eddyem/scorpio/kicad/stm8_platform/stepper_bom.ods

Component | Description | Value | Footprint | Quantity Per PCB |  | ЦЕНА
1 |  | 0.1 | C_0805_HandSoldering | 3 | есть
2 |  | 1u | C_0805_HandSoldering | 1 | 100 | 237
3 | Polarised capacitor | 47мкФ, 10В | CP_Tantalum_Case-C_EIA-6032-28_Hand | 1 | 50 | 85
4 |  | белый светодиод | LED_0805 | 1 | 25 | 140
5 | TVS Diode Array, 5.5V Standoff, 4 Channels, SOT-23-5 package | SP0504BAHT | SOT-23-5_HandSoldering | 1 | 25 | 240
6 | Connector, single row, 01x05, pin header | SWIM | штыревой разъем угловой 1x40 («мама») | 1 | (PBS-1x40R) 25 | 460
7 | Connector, single row, 01x04, pin header | UART | Pin_Header_Angled_1x04_Pitch2.54mm | 1 | -
8 | Transistor P-MOSFET with substrate diode (general) | AO3401 | SOT-23_Handsoldering | 3 | есть
9 | Transistor N-MOSFETwith substrate diode (general) | SI2300 | SOT-23_Handsoldering | 3 | есть
10 |  | 10k | R_0805_HandSoldering | 10 | есть
11 |  | 220 | R_0805_HandSoldering | 4 | есть
12 |  | 330 | R_0805_HandSoldering | 3 | есть
13 |  | 470 | R_0805_HandSoldering | 1 | есть
14 | 3x DIP Switch, Single Pole Single Throw (SPST) switch, small symbol | dip-переключатель 3 позиции | DIP-6_W7.62mm | 1 | 10 | 700
15 |  | LD1117S50CTR | SOT-223 | 1 | 20 | 235
16 |  | STM8S105K4T6C | LQFP-32_7x7mm_Pitch0.8mm | 1 | 10 | 1000
17 | Darlington Transistor Arrays | ULN2803A | SOIC-18W_7.5x11.6mm_Pitch1.27mm | 1 | 10 | 430
18 | Stepper driver | DRV8825PWP | HTSSOP (28) | 2 | 10 | 2700
 |  |  |  |  | сумма: | 6227
