eddyem/scorpio/kicad/stm8_platform/stepper_sch.pdf

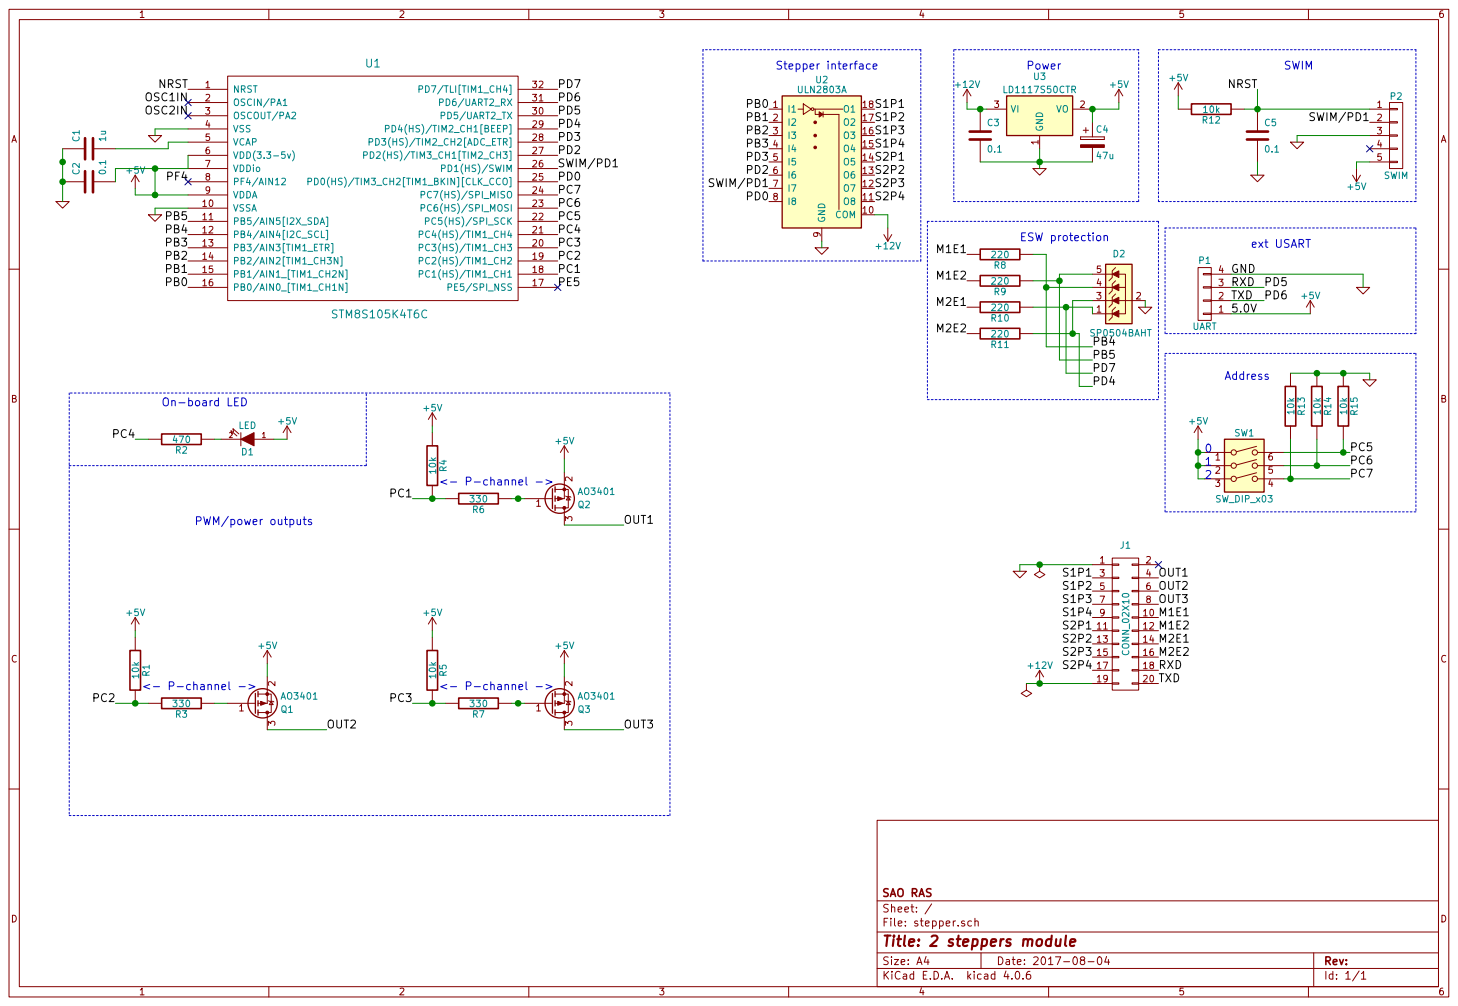
[picture p1: page 1]

+5V | SWIM

5 P2 SWIM SWIM/PD1 3

File: stepper.sch Sheet: / SAO RAS

Id: 1/1 Title: 2 steppers module
