eddyem/scorpio/kicad/stm8_platform/stepper-brd.pdf

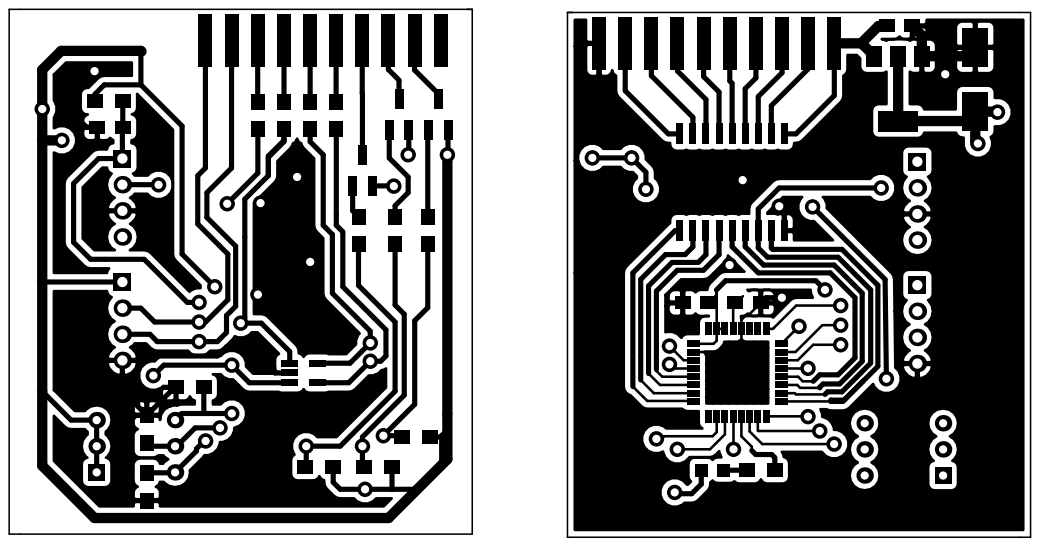
[picture p2: page 1]
