eddyem/scorpio/kicad/stm8_platform/shutter.kicad_pcb

## KiCad design kicad/stm8_platform/shutter.kicad_pcb (2018-12-14)

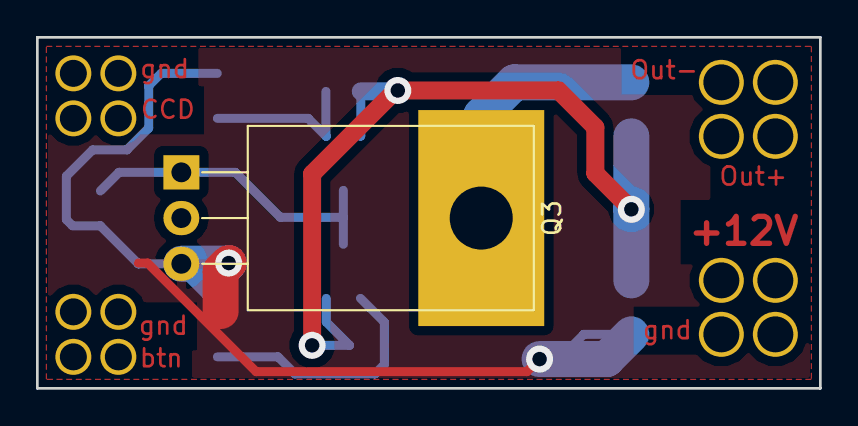
[picture p3: board shutter.kicad_pcb from above]

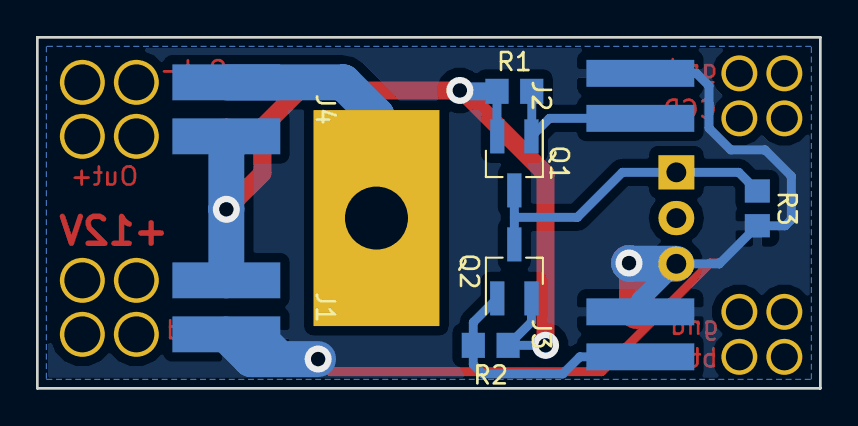
[picture p4: board shutter.kicad_pcb from below]

Board: 2 copper layers, 43.5 x 19.5 mm, 10 parts (9 on the bottom side), 6 nets.

Parts:
J1: Power; 2PIN_Pwr
J2: CCD; 2PIN
J3: Button; 2PIN
J4: Sutter; 2PIN_Pwr
Q1, Q2: AO3407; SOT-23_Handsoldering
Q3: IRL3303; TO-220-3_Horizontal_TabDown
R1, R2, R3: 47k; R_0805_2012Metric_Pad1.29x1.40mm_HandSolder

Connections:
+12V: J1.2, J4.1, Q1.2, Q2.2, R1.1, R2.1
GND: J1.1, J2.1, J3.1, Q3.3, R3.2
unnamed: J2.2, Q1.1, R1.2
unnamed: J3.2, Q2.1, R2.2
unnamed: J4.2, Q3.2
unnamed: Q1.3, Q2.3, Q3.1, R3.1
