eddyem/scorpio/kicad/stm8_platform/stepper_motherboard.kicad_pcb

## KiCad design kicad/stm8_platform/stepper_motherboard.kicad_pcb (2018-12-14)

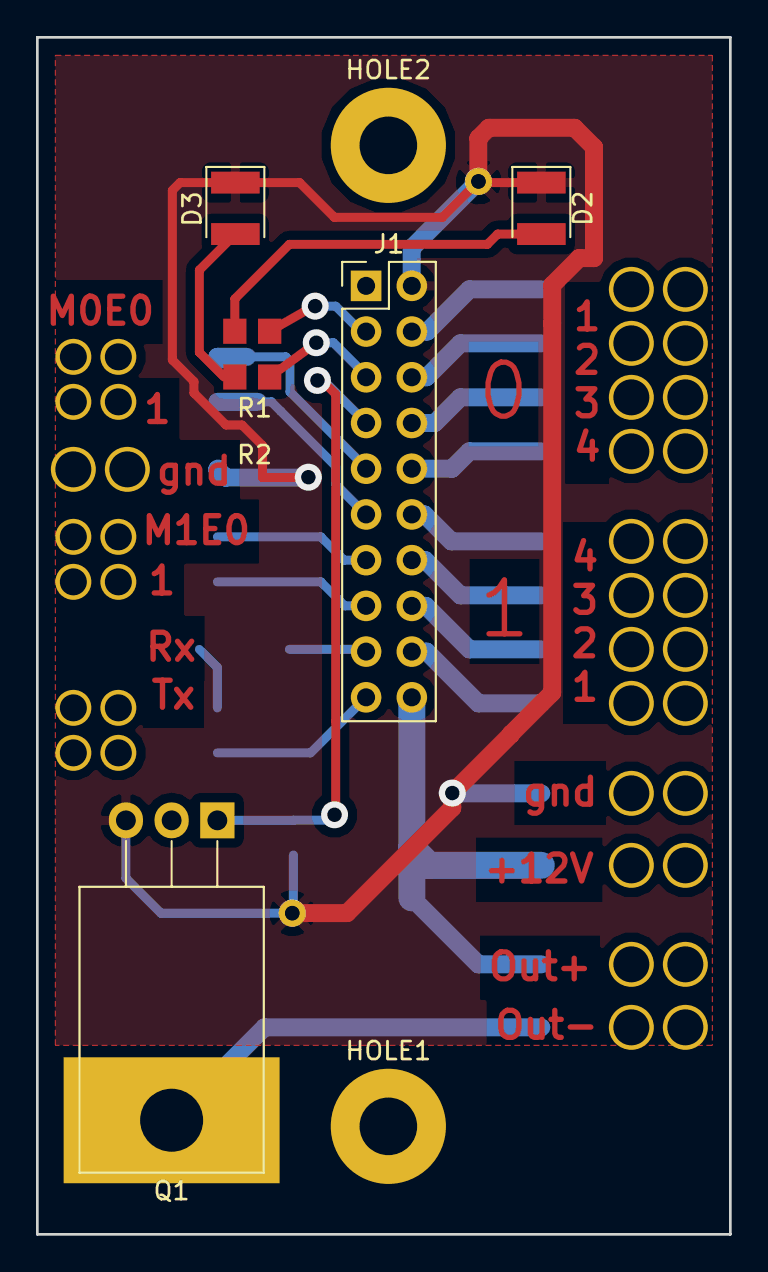
[picture p5: board stepper_motherboard.kicad_pcb from above]

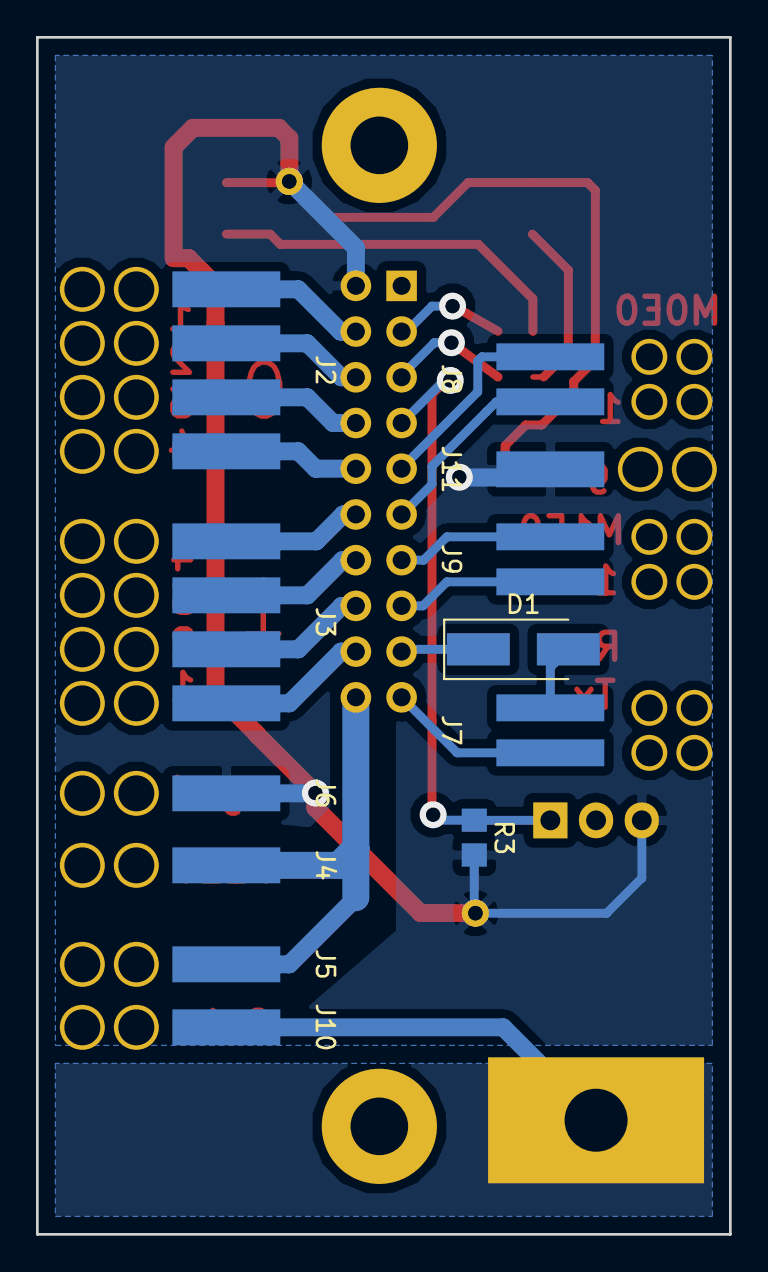
[picture p6: board stepper_motherboard.kicad_pcb from below]

Board: 2 copper layers, 38.5 x 66.5 mm, 20 parts (12 on the bottom side), 23 nets.

Parts:
D1: SS14; D_SMA_Handsoldering
D2, D3: LED; LED_1210_3225Metric_Pad1.22x2.70mm_HandSolder
HOLE1, HOLE2: HOLE; MountingHole_3.2mm_M3_Pad
J1: CONN_02X10; PinHeader_2x10_P2.54mm_Vertical
J2: Motor1; 4PIN
J3: Motor2; 4PIN
J4: 12V; 1PIN
J5: Load_12V; 1PIN
J6: GND; 1PIN
J7: UART; 2PIN
J8: Esw0; 2PIN
J9: Esw1; 2PIN
J10: Load_GND; 1PIN
J11: ESW_GND; 1PIN
Q1: IRL3303; TO-220-3_Horizontal_TabDown
R1, R2: 47; R_0805_2012Metric_Pad1.29x1.40mm_HandSolder
R3: 10k; R_0805_2012Metric_Pad1.29x1.40mm_HandSolder

Connections:
/M1E1: J1.9, J8.1
/M1E2: J1.11, J8.2
/M2E1: J1.13, J9.1
/M2E2: J1.15, J9.2
/OUT1: J1.3, R1.1
/OUT2: J1.5, R2.1
/OUT3: J1.7, Q1.1, R3.1
/RXD: J1.19, J7.2
/S0P1: J1.4, J2.4
/S0P2: J1.6, J2.3
/S0P3: J1.8, J2.2
/S0P4: J1.10, J2.1
/S1P1: J1.18, J3.1
/S1P2: J1.16, J3.2
/S1P3: J1.14, J3.3
/S1P4: J1.12, J3.4
/TXD: D1.1, J1.17
GND: D2.1, D3.1, J1.2, J6.1, J11.1, Q1.3, R3.2
unnamed: D1.2, J7.1
unnamed: D2.2, R1.2
unnamed: D3.2, R2.2
unnamed: J1.20, J4.1, J5.1
unnamed: J10.1, Q1.2
