eddyem/scorpio/kicad/stm8_platform/stepper.kicad_pcb

## KiCad design kicad/stm8_platform/stepper.kicad_pcb (2018-12-14)

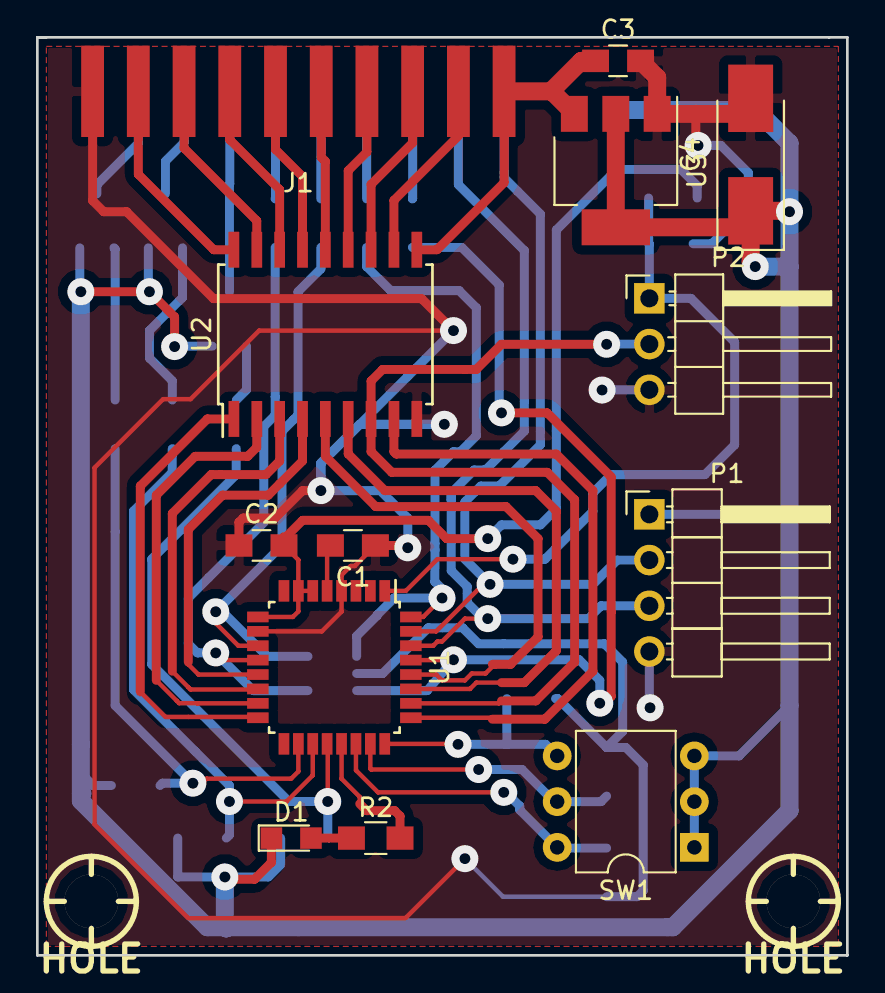
[picture p7: board stepper.kicad_pcb from above]

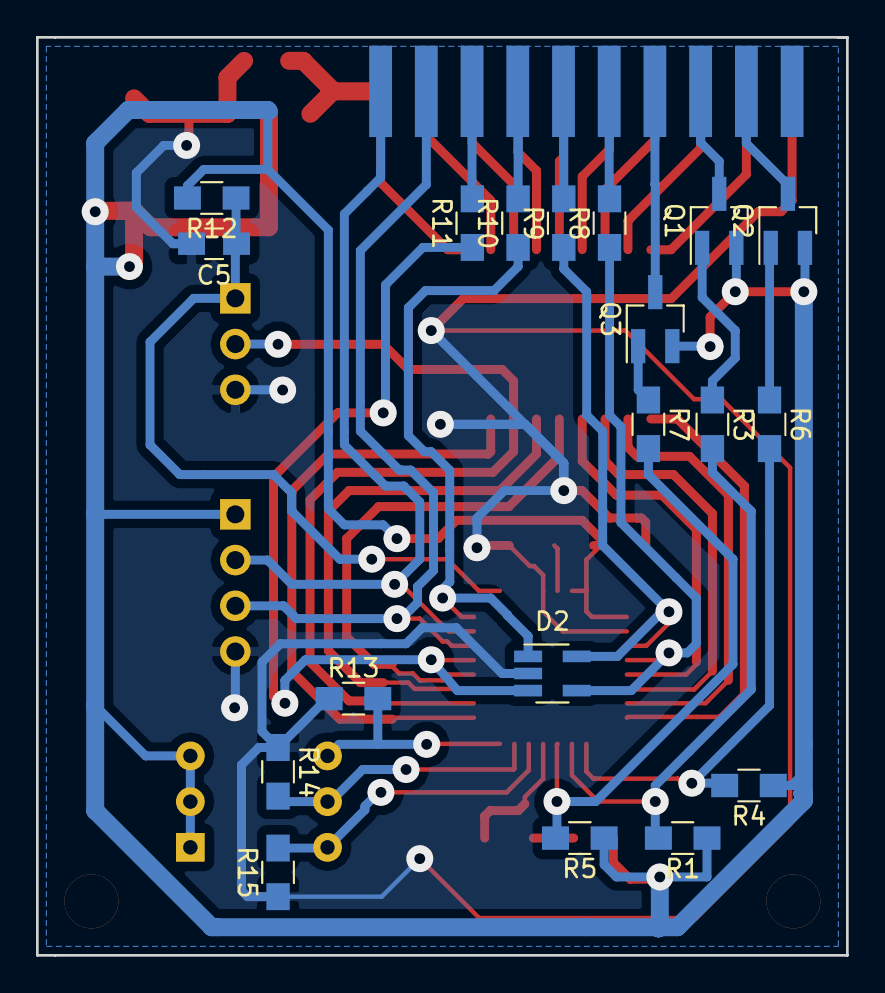
[picture p8: board stepper.kicad_pcb from below]

Board: 2 copper layers, 45.0 x 51.0 mm, 34 parts (19 on the bottom side), 45 nets.

Parts:
C1: 1u; C_0805_HandSoldering
C2, C3, C5: 0.1; C_0805_HandSoldering
C4: 47u; CP_Tantalum_Case-C_EIA-6032-28_Hand
D1: LED; LED_0805
D2: SP0504BAHT; SOT-23-5_HandSoldering
HOLE1, HOLE2: HOLE; hole_3mm
J1: CONN_02X10; Pin_header_2x10_side
P1: UART; Pin_Header_Angled_1x04_Pitch2.54mm
P2: SWIM; PinHeader_1x03_P2.54mm_Horizontal
Q1, Q2, Q3: AO3401; SOT-23_Handsoldering
R1, R4, R5, R12, R13, R14, R15: 10k; R_0805_HandSoldering
R2: 470; R_0805_HandSoldering
R3, R6, R7: 330; R_0805_HandSoldering
R8, R9, R10, R11: 220; R_0805_HandSoldering
SW1: SW_DIP_x03; DIP-6_W7.62mm
U1: STM8S105K4T6C; LQFP-32_7x7mm_Pitch0.8mm
U2: ULN2803A; SOIC-18W_7.5x11.6mm_Pitch1.27mm
U3: LD1117S50CTR; SOT-223

Connections:
+5V: C2.2, C4.1, D1.1, P1.1, Q1.2, Q2.2, Q3.2, R1.1, R4.1, R5.1, R12.2, SW1.1, SW1.2, SW1.3, U1.6, U1.7, U1.9, U3.2, U3.4
+12V: C3.1, J1.19, U2.10, U3.3
/M1E1: J1.10, R8.2
/M1E2: J1.12, R9.2
/M2E1: J1.14, R10.2
/M2E2: J1.16, R11.2
/NRST: C5.1, P2.1, R12.1, U1.1
/OUT1: J1.4, Q2.3
/OUT2: J1.6, Q1.3
/OUT3: J1.8, Q3.3
/PB0: U1.16, U2.1
/PB1: U1.15, U2.2
/PB2: U1.14, U2.3
/PB3: U1.13, U2.4
/PB4: D2.4, R8.1, U1.12
/PB5: D2.5, R9.1, U1.11
/PC1: R4.2, R6.2, U1.18
/PC2: R1.2, R3.2, U1.19
/PC3: R5.2, R7.2, U1.20
/PC4: R2.2, U1.21
/PC5: R15.2, SW1.6, U1.22
/PC6: R14.2, SW1.5, U1.23
/PC7: R13.2, SW1.4, U1.24
/PD0: U1.25, U2.8
/PD2: U1.27, U2.6
/PD3: U1.28, U2.5
/PD4: D2.3, R11.1, U1.29
/PD5: J1.18, P1.3, U1.30
/PD6: J1.20, P1.2, U1.31
/PD7: D2.1, R10.1, U1.32
/S1P1: J1.3, U2.18
/S1P2: J1.5, U2.17
/S1P3: J1.7, U2.16
/S1P4: J1.9, U2.15
/S2P1: J1.11, U2.14
/S2P2: J1.13, U2.13
/S2P3: J1.15, U2.12
/S2P4: J1.17, U2.11
/SWIM/PD1: P2.2, U1.26, U2.7
GND: C1.1, C2.1, C3.2, C4.2, C5.2, D2.2, J1.1, P1.4, P2.3, R13.1, R14.1, R15.1, U1.4, U1.10, U2.9, U3.1
unnamed: C1.2, U1.5
unnamed: D1.2, R2.1
unnamed: Q1.1, R3.1
unnamed: Q2.1, R6.1
unnamed: Q3.1, R7.1
