eddyem/scorpio/kicad/stm8_platform/kicad.kicad_pcb

## KiCad design kicad/stm8_platform/kicad.kicad_pcb (2017-08-18)

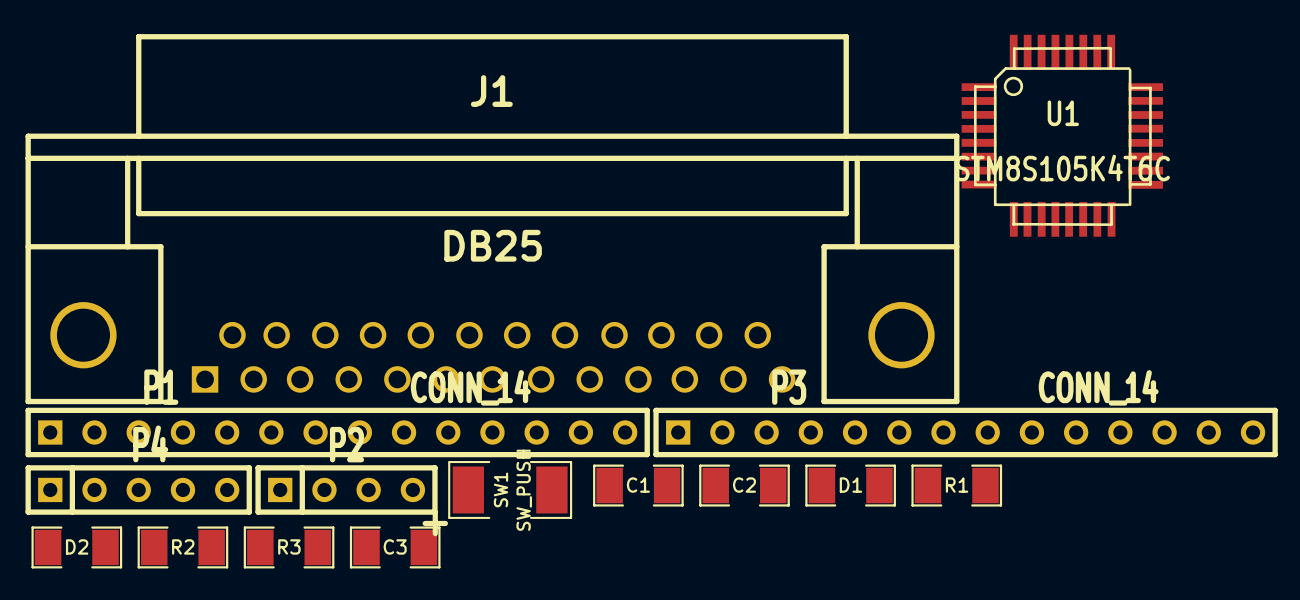
[picture p9: board kicad.kicad_pcb from above]

Board: 2 copper layers, 15 parts (0 on the bottom side), 31 nets, no tracks yet.

Parts:
C1: 1u; SM1206
C2, C3: 104; SM1206
D1, D2: LED; SM1206
J1: DB25; DB25FC
P1, P3: CONN_14; SIL-14
P2: CONN_4; SIL-4
P4: CONN_5; SIL-5
R1, R2: 1k; SM1206
R3: 10k; SM1206
SW1: SW_PUSH; SM2010
U1: STM8S105K4T6C; TQFP32

Connections:
+3.3V: C2.2, D1.1, D2.1, P1.1, P2.1, P4.1, R3.1, U1.6, U1.7, U1.9
/A DIR: J1.9, P1.9, U1.13
/NRST: C3.1, P1.3, P2.3, R3.2, SW1.2, U1.1
/OSC1IN: P1.4, U1.2
/OSC2IN: P1.5, U1.3
/PB0: J1.3, P1.12, U1.16
/PB1: J1.5, P1.11, U1.15
/PB2: J1.7, P1.10, U1.14
/PB4: P1.8, U1.12
/PB5: P1.7, U1.11
/PC1: J1.2, P1.14, U1.18
/PC2: P3.14, R1.2, U1.19
/PC3: P3.13, U1.20
/PC4: P3.12, U1.21
/PC5: P3.11, U1.22
/PC6: P3.10, U1.23
/PC7: P3.9, U1.24
/PD0: P3.8, U1.25
/PD2: J1.6, P3.6, U1.27
/PD3: P3.5, U1.28
/PD4: J1.4, P3.4, U1.29
/PD5: P3.3, P4.4, U1.30
/PD6: P3.2, P4.3, U1.31
/PD7: P3.1, U1.32
/PE5: P1.13, U1.17
/PF4: P1.6, U1.8
/SWIM/PD1: P2.2, P3.7, U1.26
GND: C1.1, C2.1, C3.2, J1.18, J1.19, J1.20, J1.21, J1.22, J1.23, J1.24, J1.25, P1.2, P2.4, P4.5, R2.2, SW1.1, U1.4, U1.10
unnamed: D2.2, R2.1
unnamed: C1.2, U1.5
unnamed: D1.2, R1.1
