eddyem/scorpio/STM8/platform/stm8l.h

/*
 * stm8l.h
 *
 * Copyright 2014 Edward V. Emelianoff <eddy@sao.ru>
 *
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
 * You should have received a copy of the GNU General Public License
 * along with this program; if not, write to the Free Software
 * Foundation, Inc., 51 Franklin Street, Fifth Floor, Boston,
 * MA 02110-1301, USA.
 */


#pragma once
#ifndef __STM8L_H__
#define __STM8L_H__

typedef unsigned char U8;
typedef unsigned int U16;
typedef unsigned long U32;
#define NULL (void*)0

/* functions */
#define enableInterrupts()    {__asm__("rim\n");}    // enable interrupts
#define disableInterrupts()   {__asm__("sim\n");}    // disable interrupts
#define iret()                {__asm__("iret\n");}   // Interrupt routine return
#define pop_ccr()             {__asm__("pop cc\n");} // Pop CCR from the stack
#define push_ccr()            {__asm__("push cc\n");}// Push CCR on the stack
#define rim()                 {__asm__("rim\n");}    // enable interrupts
#define sim()                 {__asm__("sim\n");}    // disable interrupts
#define nop()                 {__asm__("nop\n");}    // No Operation
#define trap()                {__asm__("trap\n");}   // Trap (soft IT)
#define wfi()                 {__asm__("wfi\n");}    // Wait For Interrupt
#define halt()                {__asm__("halt\n");}   // Halt

/*
 * Registers map is shown in short datasheet, page 26
 */
/* GPIO */
#define PA_ODR *(unsigned char*)0x5000
#define PA_IDR *(unsigned char*)0x5001
#define PA_DDR *(unsigned char*)0x5002
#define PA_CR1 *(unsigned char*)0x5003
#define PA_CR2 *(unsigned char*)0x5004

#define PB_ODR *(unsigned char*)0x5005
#define PB_IDR *(unsigned char*)0x5006
#define PB_DDR *(unsigned char*)0x5007
#define PB_CR1 *(unsigned char*)0x5008
#define PB_CR2 *(unsigned char*)0x5009

#define PC_ODR *(unsigned char*)0x500A
#define PC_IDR *(unsigned char*)0x500B
#define PC_DDR *(unsigned char*)0x500C
#define PC_CR1 *(unsigned char*)0x500D
#define PC_CR2 *(unsigned char*)0x500E

#define PD_ODR *(unsigned char*)0x500F
#define PD_IDR *(unsigned char*)0x5010
#define PD_DDR *(unsigned char*)0x5011
#define PD_CR1 *(unsigned char*)0x5012
#define PD_CR2 *(unsigned char*)0x5013

#define PE_ODR *(unsigned char*)0x5014
#define PE_IDR *(unsigned char*)0x5015
#define PE_DDR *(unsigned char*)0x5016
#define PE_CR1 *(unsigned char*)0x5017
#define PE_CR2 *(unsigned char*)0x5018

#define PF_ODR *(unsigned char*)0x5019
#define PF_IDR *(unsigned char*)0x501A
#define PF_DDR *(unsigned char*)0x501B
#define PF_CR1 *(unsigned char*)0x501C
#define PF_CR2 *(unsigned char*)0x501D

#ifdef STM8S105
#define PG_ODR *(unsigned char*)0x501E
#define PG_IDR *(unsigned char*)0x501F
#define PG_DDR *(unsigned char*)0x5020
#define PG_CR1 *(unsigned char*)0x5021
#define PG_CR2 *(unsigned char*)0x5022

#define PH_ODR *(unsigned char*)0x5023
#define PH_IDR *(unsigned char*)0x5024
#define PH_DDR *(unsigned char*)0x5025
#define PH_CR1 *(unsigned char*)0x5026
#define PH_CR2 *(unsigned char*)0x5027

#define PI_ODR *(unsigned char*)0x5028
#define PI_IDR *(unsigned char*)0x5029
#define PI_DDR *(unsigned char*)0x502A
#define PI_CR1 *(unsigned char*)0x502B
#define PI_CR2 *(unsigned char*)0x502C
#endif // STM8S105

/* GPIO bits */
#define GPIO_PIN0       (1 << 0)
#define GPIO_PIN1       (1 << 1)
#define GPIO_PIN2       (1 << 2)
#define GPIO_PIN3       (1 << 3)
#define GPIO_PIN4       (1 << 4)
#define GPIO_PIN5       (1 << 5)
#define GPIO_PIN6       (1 << 6)
#define GPIO_PIN7       (1 << 7)

/* -------------------- FLASH/EEPROM -------------------- */
#define FLASH_CR1   *(unsigned char*)0x505A
#define FLASH_CR2   *(unsigned char*)0x505B
#define FLASH_NCR2  *(unsigned char*)0x505C
#define FLASH_FPR   *(unsigned char*)0x505D
#define FLASH_NFPR  *(unsigned char*)0x505E
#define FLASH_IAPSR *(unsigned char*)0x505F
#define FLASH_PUKR  *(unsigned char*)0x5062 // progmem unprotection
#define FLASH_DUKR  *(unsigned char*)0x5064 // EEPROM unprotection

#define EEPROM_KEY1     0xAE  // keys to manage EEPROM's write access
#define EEPROM_KEY2     0x56
#define EEPROM_START_ADDR  (unsigned char*)0x4000

/* ------------------- interrupts ------------------- */
#define EXTI_CR1    *(unsigned char*)0x50A0
#define EXTI_CR2    *(unsigned char*)0x50A1
#define INTERRUPT_HANDLER(fn, num)      void fn() __interrupt(num)
#define INTERRUPT_DEFINITION(fn, num)   extern void fn() __interrupt(num)

// Reset status register
#define RST_SR      *(unsigned char*)0x50B3

/* ------------------- CLOCK ------------------- */
#define CLK_ICKR        *(unsigned char*)0x50C0
#define CLK_ECKR        *(unsigned char*)0x50C1
#define CLK_CMSR        *(unsigned char*)0x50C3
#define CLK_SWR         *(unsigned char*)0x50C4
#define CLK_SWCR        *(unsigned char*)0x50C5
#define CLK_CKDIVR      *(unsigned char*)0x50C6
#define CLK_SPCKENR1    *(unsigned char*)0x50C7
#define CLK_CSSR        *(unsigned char*)0x50C8
#define CLK_CCOR        *(unsigned char*)0x50C9
#define CLK_PCKENR2     *(unsigned char*)0x50CA
#define CLK_HSITRIMR    *(unsigned char*)0x50CC
#define CLK_SWIMCCR     *(unsigned char*)0x50CD

/* ------------------- Watchdog ------------------ */
#define WWDG_CR         *(unsigned char*)0x50D1
#define WWDG_WR         *(unsigned char*)0x50D2
#define IWDG_KR         *(unsigned char*)0x50E0
#define IWDG_PR         *(unsigned char*)0x50E1
#define IWDG_RLR        *(unsigned char*)0x50E2
// enable Watchdog
#define KEY_ENABLE      (0xCC)
// refresh Watchdog from IWDG_RLR
#define KEY_REFRESH     (0xAA)
// modify IWDG_PR and IWDG_RLR
#define KEY_ACCESS      (0x55)

/* ------------------- AWU, BEEP ------------------- */
#define AWU_CSR1        *(unsigned char*)0x50F0
#define AWU_APR         *(unsigned char*)0x50F1
#define AWU_TBR         *(unsigned char*)0x50F2
#define BEEP_CSR        *(unsigned char*)0x50F3

/* ------------------- SPI ------------------- */
#define SPI_CR1         *(unsigned char*)0x5200
#define SPI_CR2         *(unsigned char*)0x5201
#define SPI_ICR         *(unsigned char*)0x5202
#define SPI_SR          *(unsigned char*)0x5203
#define SPI_DR          *(unsigned char*)0x5204
#define SPI_CRCPR       *(unsigned char*)0x5205
#define SPI_RXCRCR      *(unsigned char*)0x5206
#define SPI_TXCRCR      *(unsigned char*)0x5207
// SPI_CR1 (page 271): | LSBFIRST | SPE | BR[2:0] | MSTR | CPOL | CPHA |
#define SPI_CR1_LSBFIRST (1<<7)
#define SPI_CR1_SPE      (1<<6)
#define SPI_CR1_BRMASK   (0x38)
#define SPI_CR1_MSTR     (1<<2)
#define SPI_CR1_CPOL     (1<<1)
#define SPI_CR1_CPHA     (1)
// SPI_CR2 (page 272): | BDM | BDOE | CRCEN | CRCNEXT | - | RXONLY | SSM | SSI |
#define SPI_CR2_BDM      (1<<7)
#define SPI_CR2_BDOE     (1<<6)
#define SPI_CR2_CRCEN    (1<<5)
#define SPI_CR2_CRCNEXT  (1<<4)
#define SPI_CR2_RXONLY   (1<<2)
#define SPI_CR2_SSM      (1<<1)
#define SPI_CR2_SSI      (1)
// SPI_ICR (page 273): | TXIE | RXIE | ERRIE | WKIE | - | - | - | - |
#define SPI_ICR_TXIE     (1<<7)
#define SPI_ICR_RXIE     (1<<6)
#define SPI_ICR_ERRIE    (1<<5)
#define SPI_ICR_WKIE     (1<<4)
// SPI_SR (page 274):  | BSY | OVR | MODF | CRCERR | WKUP | - | TXE | RXNE |
#define SPI_SR_BSY       (1<<7)
#define SPI_SR_OVR       (1<<6)
#define SPI_SR_MODF      (1<<5)
#define SPI_SR_CRCERR    (1<<4)
#define SPI_SR_WKUP      (1<<3)
#define SPI_SR_TXE       (1<<1)
#define SPI_SR_RXNE      (1)

/* ------------------- I2C ------------------- */
#define I2C_CR1         *(unsigned char*)0x5210
#define I2C_CR2         *(unsigned char*)0x5211
#define I2C_FREQR       *(unsigned char*)0x5212
#define I2C_OARL        *(unsigned char*)0x5213
#define I2C_OARH        *(unsigned char*)0x5214
#define I2C_DR          *(unsigned char*)0x5216
#define I2C_SR1         *(unsigned char*)0x5217
#define I2C_SR2         *(unsigned char*)0x5218
#define I2C_SR3         *(unsigned char*)0x5219
#define I2C_ITR         *(unsigned char*)0x521A
#define I2C_CCRL        *(unsigned char*)0x521B
#define I2C_CCRH        *(unsigned char*)0x521C
#define I2C_TRISER      *(unsigned char*)0x521D
#define I2C_PECR        *(unsigned char*)0x521E

/* ------------------- UART ------------------- */
#ifdef STM8S003
#define UART1_SR    *(unsigned char*)0x5230
#define UART1_DR    *(unsigned char*)0x5231
#define UART1_BRR1  *(unsigned char*)0x5232
#define UART1_BRR2  *(unsigned char*)0x5233
#define UART1_CR1   *(unsigned char*)0x5234
#define UART1_CR2   *(unsigned char*)0x5235
#define UART1_CR3   *(unsigned char*)0x5236
#define UART1_CR4   *(unsigned char*)0x5237
#define UART1_CR5   *(unsigned char*)0x5238
#define UART1_GTR   *(unsigned char*)0x5239
#define UART1_PSCR  *(unsigned char*)0x523A
#endif // STM8S003
#ifdef STM8S105
#define UART2_SR    *(unsigned char*)0x5240
#define UART2_DR    *(unsigned char*)0x5241
#define UART2_BRR1  *(unsigned char*)0x5242
#define UART2_BRR2  *(unsigned char*)0x5243
#define UART2_CR1   *(unsigned char*)0x5244
#define UART2_CR2   *(unsigned char*)0x5245
#define UART2_CR3   *(unsigned char*)0x5246
#define UART2_CR4   *(unsigned char*)0x5247
#define UART2_CR5   *(unsigned char*)0x5248
#define UART2_CR6   *(unsigned char*)0x5249
#define UART2_GTR   *(unsigned char*)0x524A
#define UART2_PSCR  *(unsigned char*)0x524B
#endif // STM8S105

/* UART_CR1 bits */
#define UART_CR1_R8 (1 << 7)
#define UART_CR1_T8 (1 << 6)
#define UART_CR1_UARTD (1 << 5)
#define UART_CR1_M (1 << 4)
#define UART_CR1_WAKE (1 << 3)
#define UART_CR1_PCEN (1 << 2)
#define UART_CR1_PS (1 << 1)
#define UART_CR1_PIEN (1 << 0)

/* UART_CR2 bits */
#define UART_CR2_TIEN (1 << 7)
#define UART_CR2_TCIEN (1 << 6)
#define UART_CR2_RIEN (1 << 5)
#define UART_CR2_ILIEN (1 << 4)
#define UART_CR2_TEN (1 << 3)
#define UART_CR2_REN (1 << 2)
#define UART_CR2_RWU (1 << 1)
#define UART_CR2_SBK (1 << 0)

/* USART_CR3 bits */
#define UART_CR3_LINEN (1 << 6)
#define UART_CR3_STOP2 (1 << 5)
#define UART_CR3_STOP1 (1 << 4)
#define UART_CR3_CLKEN (1 << 3)
#define UART_CR3_CPOL (1 << 2)
#define UART_CR3_CPHA (1 << 1)
#define UART_CR3_LBCL (1 << 0)

/* UART_SR bits */
#define UART_SR_TXE (1 << 7)
#define UART_SR_TC (1 << 6)
#define UART_SR_RXNE (1 << 5)
#define UART_SR_IDLE (1 << 4)
#define UART_SR_OR (1 << 3)
#define UART_SR_NF (1 << 2)
#define UART_SR_FE (1 << 1)
#define UART_SR_PE (1 << 0)


/* ------------------- TIMERS ------------------- */
/* TIM1 */
#define TIM1_CR1    *(unsigned char*)0x5250
#define TIM1_CR2    *(unsigned char*)0x5251
#define TIM1_SMCR   *(unsigned char*)0x5252
#define TIM1_ETR    *(unsigned char*)0x5253
#define TIM1_IER    *(unsigned char*)0x5254
#define TIM1_SR1    *(unsigned char*)0x5255
#define TIM1_SR2    *(unsigned char*)0x5256
#define TIM1_EGR    *(unsigned char*)0x5257
#define TIM1_CCMR1  *(unsigned char*)0x5258
#define TIM1_CCMR2  *(unsigned char*)0x5259
#define TIM1_CCMR3  *(unsigned char*)0x525A
#define TIM1_CCMR4  *(unsigned char*)0x525B
#define TIM1_CCER1  *(unsigned char*)0x525C
#define TIM1_CCER2  *(unsigned char*)0x525D
#define TIM1_CNTRH  *(unsigned char*)0x525E
#define TIM1_CNTRL  *(unsigned char*)0x525F
#define TIM1_PSCRH  *(unsigned char*)0x5260
#define TIM1_PSCRL  *(unsigned char*)0x5261
#define TIM1_ARRH   *(unsigned char*)0x5262
#define TIM1_ARRL   *(unsigned char*)0x5263
#define TIM1_RCR    *(unsigned char*)0x5264
#define TIM1_CCR1H  *(unsigned char*)0x5265
#define TIM1_CCR1L  *(unsigned char*)0x5266
#define TIM1_CCR2H  *(unsigned char*)0x5267
#define TIM1_CCR2L  *(unsigned char*)0x5268
#define TIM1_CCR3H  *(unsigned char*)0x5269
#define TIM1_CCR3L  *(unsigned char*)0x526A
#define TIM1_CCR4H  *(unsigned char*)0x526B
#define TIM1_CCR4L  *(unsigned char*)0x526C
#define TIM1_BKR    *(unsigned char*)0x526D
#define TIM1_DTR    *(unsigned char*)0x526E
#define TIM1_OISR   *(unsigned char*)0x526F


/* TIM_IER bits */
#define TIM_IER_BIE (1 << 7)
#define TIM_IER_TIE (1 << 6)
#define TIM_IER_COMIE (1 << 5)
#define TIM_IER_CC4IE (1 << 4)
#define TIM_IER_CC3IE (1 << 3)
#define TIM_IER_CC2IE (1 << 2)
#define TIM_IER_CC1IE (1 << 1)
#define TIM_IER_UIE (1 << 0)

/* TIM_CR1 bits */
#define TIM_CR1_APRE (1 << 7)
#define TIM_CR1_CMSH (1 << 6)
#define TIM_CR1_CMSL (1 << 5)
#define TIM_CR1_DIR (1 << 4)
#define TIM_CR1_OPM (1 << 3)
#define TIM_CR1_URS (1 << 2)
#define TIM_CR1_UDIS (1 << 1)
#define TIM_CR1_CEN (1 << 0)

/* TIM_SR1 bits */
#define TIM_SR1_BIF (1 << 7)
#define TIM_SR1_TIF (1 << 6)
#define TIM_SR1_COMIF (1 << 5)
#define TIM_SR1_CC4IF (1 << 4)
#define TIM_SR1_CC3IF (1 << 3)
#define TIM_SR1_CC2IF (1 << 2)
#define TIM_SR1_CC1IF (1 << 1)
#define TIM_SR1_UIF (1 << 0)

/* TIM_EGR bits */
#define TIM_EGR_BG (1 << 7)
#define TIM_EGR_TG (1 << 6)
#define TIM_EGR_COMG (1 << 5)
#define TIM_EGR_CC4G (1 << 4)
#define TIM_EGR_CC3G (1 << 3)
#define TIM_EGR_CC2G (1 << 2)
#define TIM_EGR_CC1G (1 << 1)
#define TIM_EGR_UG (1 << 0)


/* TIM2 */
#define TIM2_CR1    *(unsigned char*)0x5300
#if defined STM8S105 || defined STM8S103
#define TIM2_IER    *(unsigned char*)0x5301
#define TIM2_SR1    *(unsigned char*)0x5302
#define TIM2_SR2    *(unsigned char*)0x5303
#define TIM2_EGR    *(unsigned char*)0x5304
#define TIM2_CCMR1  *(unsigned char*)0x5305
#define TIM2_CCMR2  *(unsigned char*)0x5306
#define TIM2_CCMR3  *(unsigned char*)0x5307
#define TIM2_CCER1  *(unsigned char*)0x5308
#define TIM2_CCER2  *(unsigned char*)0x5309
#define TIM2_CNTRH  *(unsigned char*)0x530A
#define TIM2_CNTRL  *(unsigned char*)0x530B
#define TIM2_PSCR   *(unsigned char*)0x530C
#define TIM2_ARRH   *(unsigned char*)0x530D
#define TIM2_ARRL   *(unsigned char*)0x530E
#define TIM2_CCR1H  *(unsigned char*)0x530F
#define TIM2_CCR1L  *(unsigned char*)0x5310
#define TIM2_CCR2H  *(unsigned char*)0x5311
#define TIM2_CCR2L  *(unsigned char*)0x5312
#define TIM2_CCR3H  *(unsigned char*)0x5313
#define TIM2_CCR3L  *(unsigned char*)0x5314
#elif defined STM8S003
#define TIM2_IER    *(unsigned char*)0x5303
#define TIM2_SR1    *(unsigned char*)0x5304
#define TIM2_SR2    *(unsigned char*)0x5305
#define TIM2_EGR    *(unsigned char*)0x5306
#define TIM2_CCMR1  *(unsigned char*)0x5307
#define TIM2_CCMR2  *(unsigned char*)0x5308
#define TIM2_CCMR3  *(unsigned char*)0x5309
#define TIM2_CCER1  *(unsigned char*)0x530A
#define TIM2_CCER2  *(unsigned char*)0x530B
#define TIM2_CNTRH  *(unsigned char*)0x530C
#define TIM2_CNTRL  *(unsigned char*)0x530D
#define TIM2_PSCR   *(unsigned char*)0x530E
#define TIM2_ARRH   *(unsigned char*)0x530F
#define TIM2_ARRL   *(unsigned char*)0x5310
#define TIM2_CCR1H  *(unsigned char*)0x5311
#define TIM2_CCR1L  *(unsigned char*)0x5312
#define TIM2_CCR2H  *(unsigned char*)0x5313
#define TIM2_CCR2L  *(unsigned char*)0x5314
#define TIM2_CCR3H  *(unsigned char*)0x5315
#define TIM2_CCR3L  *(unsigned char*)0x5316
#endif


/* TIM3 */
#if defined STM8S105 || defined STM8S103
#define TIM3_CR1    *(unsigned char*)0x5320
#define TIM3_IER    *(unsigned char*)0x5321
#define TIM3_SR1    *(unsigned char*)0x5322
#define TIM3_SR2    *(unsigned char*)0x5323
#define TIM3_EGR    *(unsigned char*)0x5324
#define TIM3_CCMR1  *(unsigned char*)0x5325
#define TIM3_CCMR2  *(unsigned char*)0x5326
#define TIM3_CCER1  *(unsigned char*)0x5327
#define TIM3_CNTRH  *(unsigned char*)0x5328
#define TIM3_CNTRL  *(unsigned char*)0x5329
#define TIM3_PSCR   *(unsigned char*)0x532A
#define TIM3_ARRH   *(unsigned char*)0x532B
#define TIM3_ARRL   *(unsigned char*)0x532C
#define TIM3_CCR1H  *(unsigned char*)0x532D
#define TIM3_CCR1L  *(unsigned char*)0x532E
#define TIM3_CCR2H  *(unsigned char*)0x532F
#define TIM3_CCR2L  *(unsigned char*)0x5330
#endif

/* TIM4 */
#define TIM4_CR1    *(unsigned char*)0x5340
#if defined STM8S105 || defined STM8S103
#define TIM4_IER    *(unsigned char*)0x5341
#define TIM4_SR     *(unsigned char*)0x5342
#define TIM4_EGR    *(unsigned char*)0x5343
#define TIM4_CNTR   *(unsigned char*)0x5344
#define TIM4_PSCR   *(unsigned char*)0x5345
#define TIM4_ARR    *(unsigned char*)0x5346
#elif defined STM8S003
#define TIM4_IER    *(unsigned char*)0x5343
#define TIM4_SR     *(unsigned char*)0x5344
#define TIM4_EGR    *(unsigned char*)0x5345
#define TIM4_CNTR   *(unsigned char*)0x5346
#define TIM4_PSCR   *(unsigned char*)0x5347
#define TIM4_ARR    *(unsigned char*)0x5348
#endif

/* ------------------- ADC ------------------- */
#define ADC_DB0RH   *(unsigned char*)0x53E0
#define ADC_DB0RL   *(unsigned char*)0x53E1
#define ADC_DB1RH   *(unsigned char*)0x53E2
#define ADC_DB1RL   *(unsigned char*)0x53E3
#define ADC_DB2RH   *(unsigned char*)0x53E4
#define ADC_DB2RL   *(unsigned char*)0x53E5
#define ADC_DB3RH   *(unsigned char*)0x53E6
#define ADC_DB3RL   *(unsigned char*)0x53E7
#define ADC_DB4RH   *(unsigned char*)0x53E8
#define ADC_DB4RL   *(unsigned char*)0x53E9
#define ADC_DB5RH   *(unsigned char*)0x53EA
#define ADC_DB5RL   *(unsigned char*)0x53EB
#define ADC_DB6RH   *(unsigned char*)0x53EC
#define ADC_DB6RL   *(unsigned char*)0x53ED
#define ADC_DB7RH   *(unsigned char*)0x53EE
#define ADC_DB7RL   *(unsigned char*)0x53EF
#define ADC_DB8RH   *(unsigned char*)0x53F0
#define ADC_DB8RL   *(unsigned char*)0x53F1
#define ADC_DB9RH   *(unsigned char*)0x53F2
#define ADC_DB9RL   *(unsigned char*)0x53F3
#define ADC_CSR     *(unsigned char*)0x5400
#define ADC_CR1     *(unsigned char*)0x5401
#define ADC_CR2     *(unsigned char*)0x5402
#define ADC_CR3     *(unsigned char*)0x5403
#define ADC_DRH     *(unsigned char*)0x5404
#define ADC_DRL     *(unsigned char*)0x5405
#define ADC_TDRH    *(unsigned char*)0x5406
#define ADC_TDRL    *(unsigned char*)0x5407
#define ADC_HTRH    *(unsigned char*)0x5408
#define ADC_HTRL    *(unsigned char*)0x5409
#define ADC_LTRH    *(unsigned char*)0x540A
#define ADC_LTRL    *(unsigned char*)0x540B
#define ADC_AWSRH   *(unsigned char*)0x540C
#define ADC_AWSRL   *(unsigned char*)0x540D
#define ADC_AWCRH   *(unsigned char*)0x540E
#define ADC_AWCRL   *(unsigned char*)0x540F

/* ------------------- swim control ------------------- */
#define CFG_GCR         *(unsigned char*)0x7F60
#define SWIM_CSR        *(unsigned char*)0x7F80

/* ------------------- ITC ------------------- */
#define ITC_SPR1        *(unsigned char*)0x7F70
#define ITC_SPR2        *(unsigned char*)0x7F71
#define ITC_SPR3        *(unsigned char*)0x7F72
#define ITC_SPR4        *(unsigned char*)0x7F73
#define ITC_SPR5        *(unsigned char*)0x7F74
#define ITC_SPR6        *(unsigned char*)0x7F75
#define ITC_SPR7        *(unsigned char*)0x7F76
#define ITC_SPR8        *(unsigned char*)0x7F77


/* -------------------- UNIQUE ID -------------------- */
#if defined STM8S105 || defined STM8S103 // maybe some other MCU have this too???
#define U_ID00      (unsigned char*)0x48CD
#define U_ID01      (unsigned char*)0x48CE
#define U_ID02      (unsigned char*)0x48CF
#define U_ID03      (unsigned char*)0x48D0
#define U_ID04      (unsigned char*)0x48D1
#define U_ID05      (unsigned char*)0x48D2
#define U_ID06      (unsigned char*)0x48D3
#define U_ID07      (unsigned char*)0x48D4
#define U_ID08      (unsigned char*)0x48D5
#define U_ID09      (unsigned char*)0x48D6
#define U_ID10      (unsigned char*)0x48D7
#define U_ID11      (unsigned char*)0x48D8
#endif // defined STM8S105 || defined STM8S103

// CCR REGISTER: bits 3&5 should be 1 if you wanna change EXTI_CRx
#define CCR         *(unsigned char*)0x7F0A

/* -------------------- OPTION BYTES -------------------- */
#if defined STM8S105
// readout protection
#define OPT0        *(unsigned char*)0x4800
// user boot code
#define OPT1        *(unsigned char*)0x4801
#define NOPT1       *(unsigned char*)0x4802
// alternate functions remapping
// | AFR7 | ... | AFR0 |
// AFR7 - PD4 = BEEP; AFR6 - PB4/PB5 = I2C; AFR5 - PB0..3 - TIM1
// AFR4 - PD7 = TIM1_CH4; AFR3 - PD0 = TIM1_BKIN
// AFR2 - PD0 = CLK_CCO; AFR1 - PA3 = TIM3_CH1, PD2 = TIM2_CH3
// AFR0 - PD3 = ADC_ETR
#define OPT2        *(unsigned char*)0x4803
#define NOPT2       *(unsigned char*)0x4804
// trim, watchdog
#define OPT3        *(unsigned char*)0x4805
#define NOPT3       *(unsigned char*)0x4806
// extclc, awu
#define OPT4        *(unsigned char*)0x4807
#define NOPT4       *(unsigned char*)0x4808
// HSE stab time
#define OPT5        *(unsigned char*)0x4809
#define NOPT5       *(unsigned char*)0x480a
// none
#define OPT6        *(unsigned char*)0x480b
#define NOPT6       *(unsigned char*)0x480c
// none
#define OPT7        *(unsigned char*)0x480d
#define NOPT7       *(unsigned char*)0x480e
// bootloader opt byte
#define OPTBL       *(unsigned char*)0x487e
#define NOPTBL      *(unsigned char*)0x487f

#endif

#endif // __STM8L_H__

// #define      *(unsigned char*)0x
