eddyem/scorpio/(commit log)

2017-06-30 Fixed bug with end-switches check
    [main.c, proto.c, stepper.c, stepper.h]
2017-08-18 PCB for "laser iron"
    [kicad.kicad_pcb, stepper.kicad_pcb, stepper.sch]
2017-09-23 small update
    [stepper.kicad_pcb, stepper.sch, stepper_bom.ods]
2018-04-11 Add firmware for atmega8535 based driver of SCORPIO base platform module
2018-10-09 add code for STM8-based 2stepper management board
    [stepper.kicad_pcb, stepper.sch]
2018-10-10 Final fix, all works pretty
    [motors.c, motors.h, proto.c]
2018-10-10 add russian readme, save kicad files in KiCAD-5.0
    [stepper-2018-10-10-13-48-08.sch]
2018-10-11 fixed error: STM8S have NO opendrain mode for Tx of UART!!!
    [interrupts.c, main.c, motors.c, motors.h, proto.c, uart.c, uart.h]
